fred314159265/m18-usb-interface/Images/social-preview.png

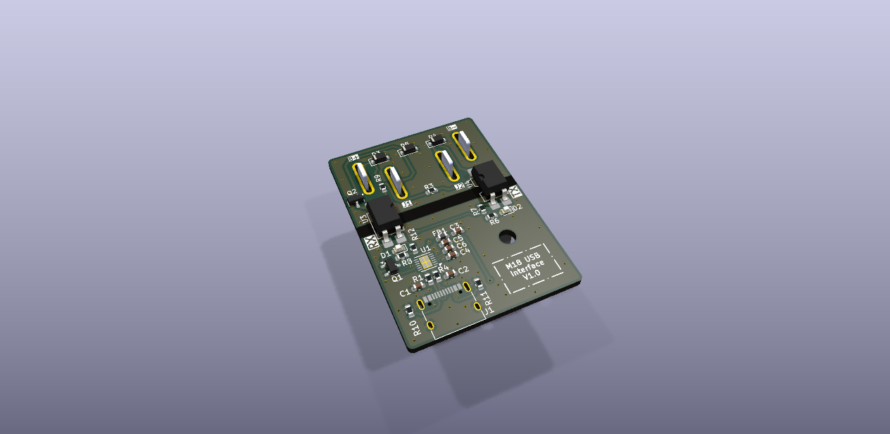
Images/social-preview.png
