fred314159265/m18-usb-interface/m18-usb-interface-pcb/Releases/v1.0/m18-usb-interface-pcb_v1.0.pdf

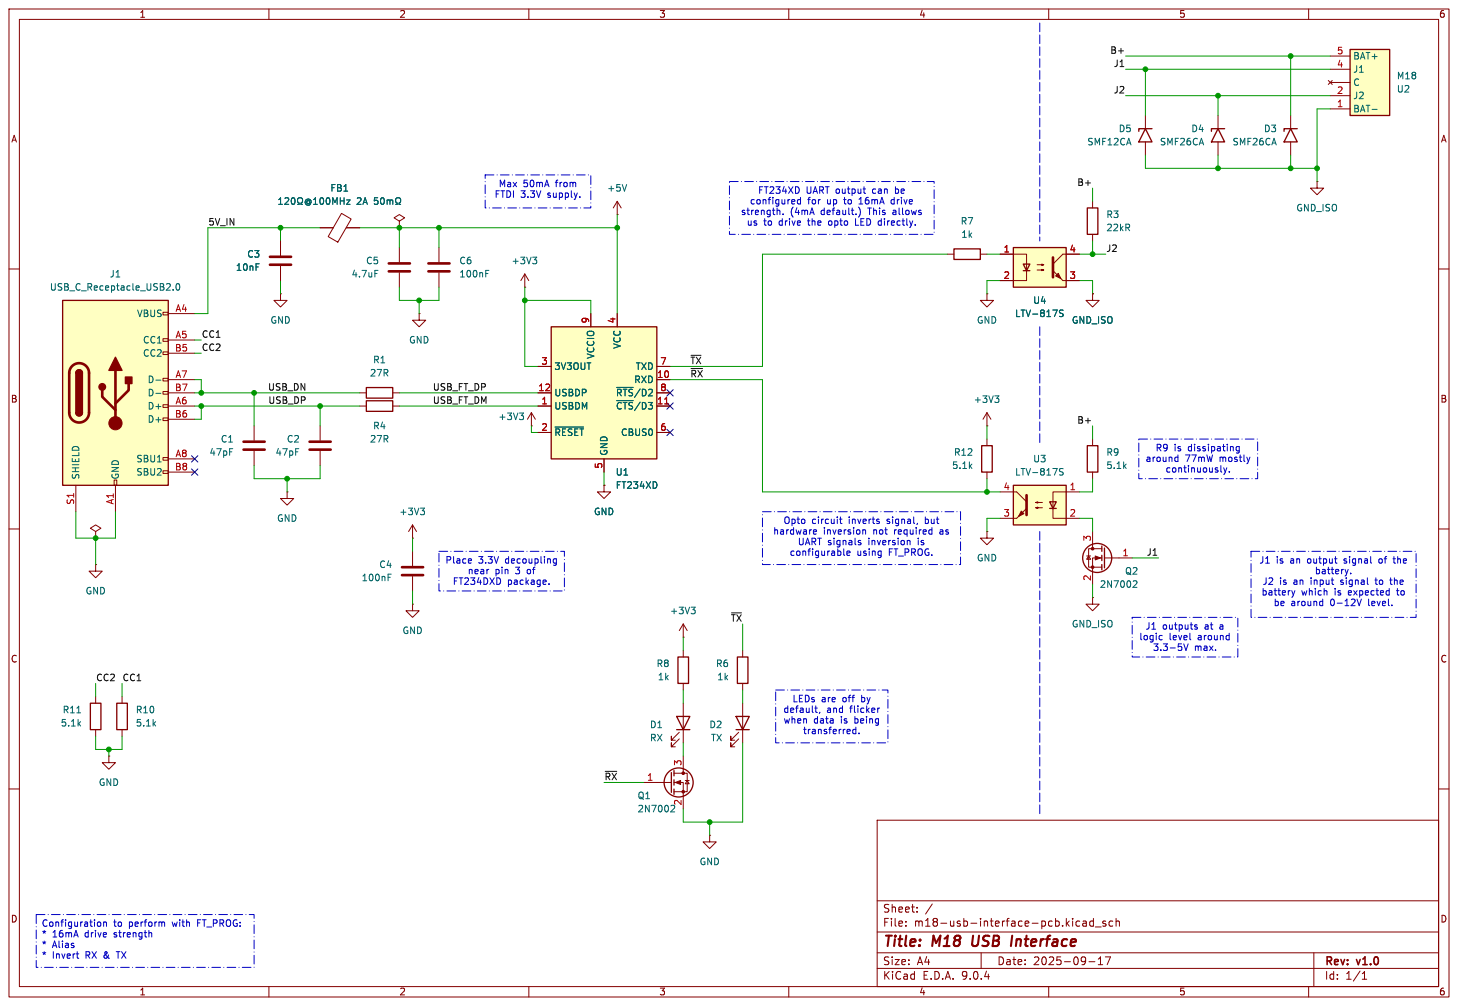
[picture p8: page 1]

4 TXD 7 RXD 10 ~{RTS}/D28 ~{CTS}/D311 CBUS0 6 FB1

FT234XD UART output can be

4 TXD 7 RXD 10 ~{RTS}/D28 ~{CTS}/D311 CBUS0 6 U1 FT234XD

File: m18-usb-interface-pcb.kicad_sch Sheet: / C4

battery. J2 is an input signal to the

battery which is expected to

Id: 1/1 Title: M18 USB Interface
