fred314159265/m18-usb-interface/m18-usb-interface-pcb/m18-usb-interface-pcb.kicad_pcb

## KiCad design m18-usb-interface-pcb/m18-usb-interface-pcb.kicad_pcb (2025-09-17)

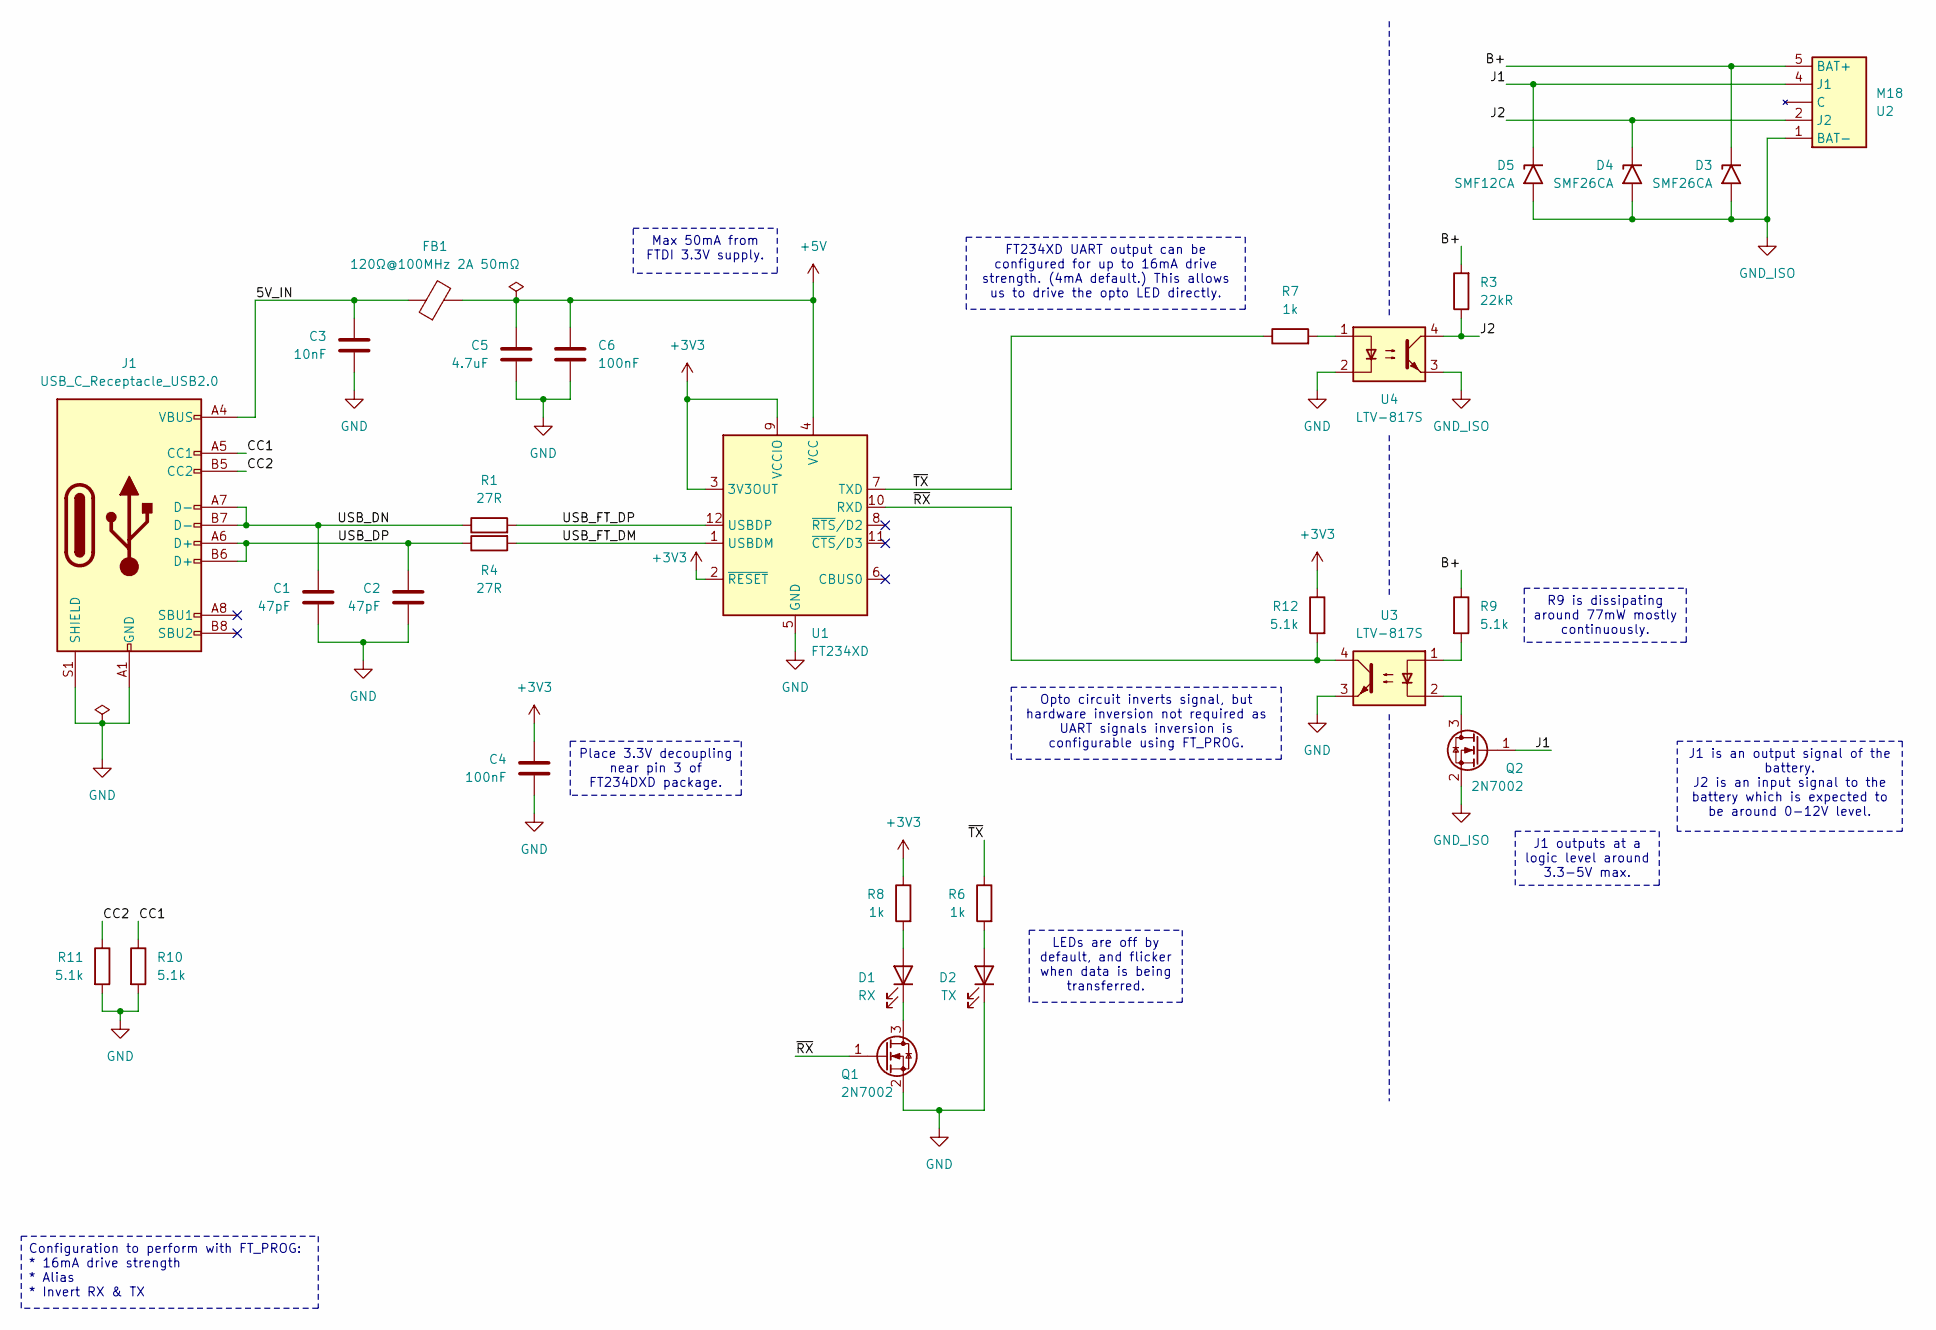
[picture p9: schematic m18-usb-interface-pcb.kicad_sch, M18 USB Interface]

Parts:
C1, C2: 47pF; C_0603_1608Metric; Manufacturer Part # CL10C470JB8NNNC; LCSC Part # C1671
C3: 10nF; C_0603_1608Metric; Manufacturer Part # 0603B103K500NT; LCSC Part # C57112
C4, C6: 100nF; C_0603_1608Metric; Manufacturer Part # CC0603KRX7R9BB104; LCSC Part # C14663
C5: 4.7uF; C_0603_1608Metric; Manufacturer Part # CL10A475KO8NNNC; LCSC Part # C19666
D1: RX; LED_0603_1608Metric; Manufacturer Part # KT-0603R; LCSC Part # C2286
D2: TX; LED_0603_1608Metric; Manufacturer Part # KT-0603R; LCSC Part # C2286
D3, D4: SMF26CA; D_SOD-123F; Manufacturer Part # SMF26CA; LCSC Part # C19077516
D5: SMF12CA; D_SOD-123F; Manufacturer Part # SMF12CA; LCSC Part # C19077507
FB1: 120Ω@100MHz 2A 50mΩ; L_0603_1608Metric; Manufacturer Part # BLM18PG121SN1D; LCSC Part # C14709
J1: USB_C_Receptacle_USB2.0; USB_C_Receptacle_XKB_U262-16XN-4BVC11; Manufacturer Part # U262-161N-4BVC11; LCSC Part # C319148
Q1, Q2: 2N7002; SOT-23; Manufacturer Part # 2N7002; LCSC Part # C8545
R1, R4: 27R; R_0603_1608Metric; Manufacturer Part # 0603WAF270JT5E; LCSC Part # C25190
R3: 22kR; R_0603_1608Metric; Manufacturer Part # 0603WAF2202T5E; LCSC Part # C31850
R6, R7, R8: 1k; R_0603_1608Metric; Manufacturer Part # 0603WAF1000T5E; LCSC Part # C22775
R9, R10, R11, R12: 5.1k; R_0603_1608Metric; Manufacturer Part # 0603WAF5101T5E; LCSC Part # C23186
U1: FT234XD; WDFN-12-1EP_3x3mm_P0.45mm_EP1.7x2.5mm; Manufacturer Part # FT234XD-R; LCSC Part # C132158
U2: M18; M18_Battery_Interface
U3, U4: LTV-817S; SMDIP-4_W9.53mm; Manufacturer Part # LTV-817S-TA1-C; LCSC Part # C109227

Connections:
+3V3: C4.1, R8.1, R12.1, U1.2 (~RESET), U1.3 (3V3OUT), U1.9 (VCCIO)
+5V: C5.1, C6.1, FB1.2, U1.4 (VCC)
/5V_IN: C3.1, FB1.1, J1.A4 (VBUS), J1.A9 (VBUS), J1.B4 (VBUS), J1.B9 (VBUS)
/B+: D3.1 (A1), R3.2, R9.1, U2.5 (BAT+)
/CC1: J1.A5 (CC1), R10.1
/CC2: J1.B5 (CC2), R11.1
/J1: D5.1 (A1), Q2.1 (G), U2.4 (J1)
/J2: D4.1 (A1), R3.1, U2.2 (J2), U4.4
/USB_DN: C1.1, J1.A7 (D-), J1.B7 (D-), R1.1
/USB_DP: C2.1, J1.A6 (D+), J1.B6 (D+), R4.1
/USB_FT_DM: R4.2, U1.1 (USBDM)
/USB_FT_DP: R1.2, U1.12 (USBDP)
/~RX: Q1.1 (G), R12.2, U1.10 (RXD), U3.4
/~TX: R6.1, R7.1, U1.7 (TXD)
GND: C1.2, C2.2, C3.2, C4.2, C5.2, C6.2, D2.1 (K), J1.A1 (GND), J1.A12 (GND), J1.B1 (GND), J1.B12 (GND), J1.S1 (SHIELD), Q1.2 (S), R10.2, R11.2, U1.5 (GND), U1.13 (GND), U3.3, U4.2
GND_ISO: D3.2 (A2), D4.2 (A2), D5.2 (A2), Q2.2 (S), U2.1 (BAT-), U4.3
unnamed: D1.2 (A), R8.2
unnamed: D1.1 (K), Q1.3 (D)
unnamed: D2.2 (A), R6.2
unnamed: Q2.3 (D), U3.2
unnamed: R7.2, U4.1
unnamed: R9.2, U3.1

Notes on the sheet:
Max 50mA from FTDI 3.3V supply.
LEDs are off by default, and flicker when data is being transferred.
J1 is an output signal of the battery. J2 is an input signal to the battery which is expected to be around 0-12V level.
R9 is dissipating around 77mW mostly continuously.
Place 3.3V decoupling near pin 3 of FT234DXD package.
Opto circuit inverts signal, but hardware inversion not required as UART signals inversion is configurable using FT_PROG.
FT234XD UART output can be configured for up to 16mA drive strength. (4mA default.) This allows us to drive the opto LED directly.
J1 outputs at a logic level around 3.3-5V max.
Configuration to perform with FT_PROG: * 16mA drive strength * Alias * Invert RX & TX

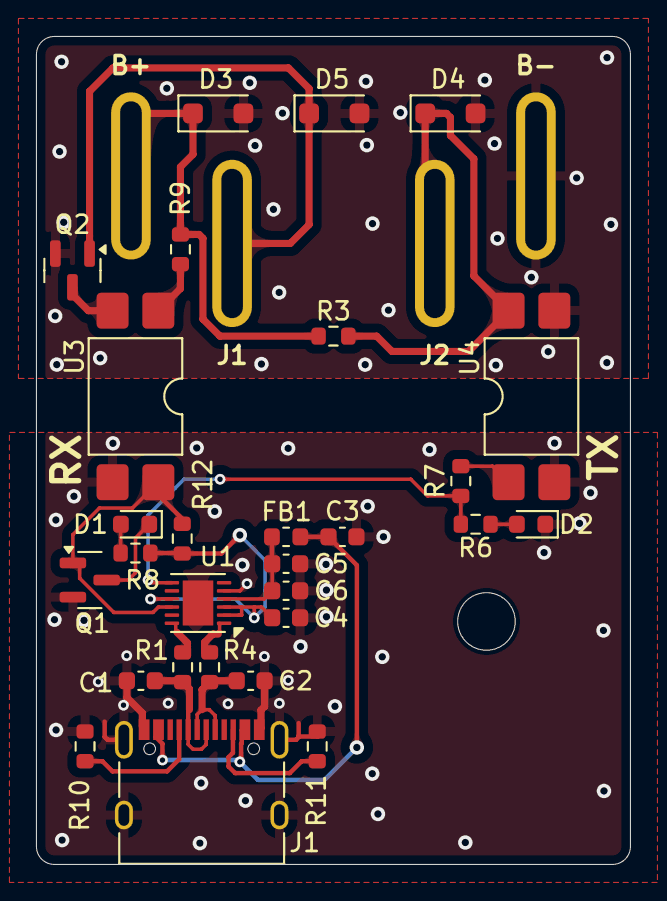
[picture p10: board m18-usb-interface-pcb.kicad_pcb from above]

Board: 2 copper layers, 33.0 x 46.0 mm, 29 parts (1 on the bottom side), 22 nets.
