fred314159265/m18-usb-interface/(commit log)

2025-09-17 v1.0 PCB released
    [m18-usb-interface-pcb.kicad_pcb, m18-usb-interface-pcb.kicad_sch]
2025-10-19 Added template file for programming FTDI setting w/ FT_Prog.
    Tracked some production outputs which were missed.
    [bom.csv, designators.csv, positions.csv]
2026-10-21 Add a project README and 3D renders of the v1.0 board.
    The GitHub landing page was the license text. The README describes the adapter, links to m18-protocol-rs, and shows renders of the committed v1.0 PCB. Stop tracking fp-info-cache.
2026-10-21 Link the interactive BOM to the rendered page.
